Hylian/sensor-watch-tcs3400/sensor_watch_lightmeter.kicad_pcb

## KiCad design sensor_watch_lightmeter.kicad_pcb (2024-10-03)

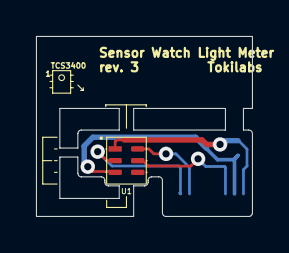
[picture p1: board sensor_watch_lightmeter.kicad_pcb from above]

Board: 2 copper layers, 12.0 x 10.0 mm, 3 parts (1 on the bottom side), 5 nets.

Parts:
C1: 1uF; C_0201_0603Metric_Pad0.64x0.40mm_HandSolder
U1: TCS3400
U2: FH19C-9S-0.5SH_10-FFC; FH19C9S05SH10-FFC

Connections:
/A4_INT: U1.5 (INT), U2.3
/SCL: U1.2 (SCL), U2.8
/SDA: U1.6 (SDA), U2.7
GND: C1.2, U1.3 (GND), U2.2
VCC: C1.1, U1.1 (VDD), U2.1
